phucnv1206/Micromouse/schematic_export.html

⚡ SƠ ĐỒ NGUYÊN LÝ MẠCH ĐIỆN MICROMOUSE STM32F401

Kiến trúc 2 Bus I2C độc lập: I2C1 (3 Cảm biến ToF + DMA) & I2C2 (MPU6050 1000Hz) • EXTI Quadrature Encoders

● Logic 3.3V STM32F401RCT6 (LQFP64)

VCC (+3.3V)

GND (Mass chung)

Bus I2C1 (PB6 SCL / PB7 SDA)

Bus I2C2 (PB10 SCL / PB3 SDA)

Encoders (EXTI11/12, EXTI4/5)

Motor PWM (TIM1_CH1, TIM11_CH1)

UART Telemetry (PA2/PA3)

🔌 Điện Trở Phụ Trợ & Cấu Hình Chân

- • R1, R2 (4.7kΩ): Điện trở kéo lên (Pull-up) cho Bus I2C1 (PB6, PB7) lên 3.3V.
- • R3, R4 (4.7kΩ): Điện trở kéo lên (Pull-up) cho Bus I2C2 (PB10, PB3) lên 3.3V.
- • 330Ω × 3: Trở hạn dòng mắc nối tiếp trước Anode của 3 đèn LED báo trạng thái.
- • PA0, PA1: Nút bấm nối trực tiếp xuống GND (dùng điện trở Pull-up nội bên trong MCU).

⚠️ Quy Chuẩn Đấu Nối Quan Trọng

- • AD0 của MPU6050: Nối cứng xuống GND để cố định địa chỉ I2C 0x68.
- • Chân PB3 (SDA I2C2): Trùng chức năng SWO, dùng mạch nạp SWD bình thường không bị ảnh hưởng.
- • Common Ground (GND chung): Bắt buộc nối Mass chung giữa nguồn Pin, Driver Motor và MCU STM32.
- • Nguồn 3.3V: Cần bộ nguồn LDO/Buck tối thiểu 800mA - 1A để nuôi MCU, 3 Laser ToF và IMU.
