phucnv1206/Micromouse/micromouse_schematic.png

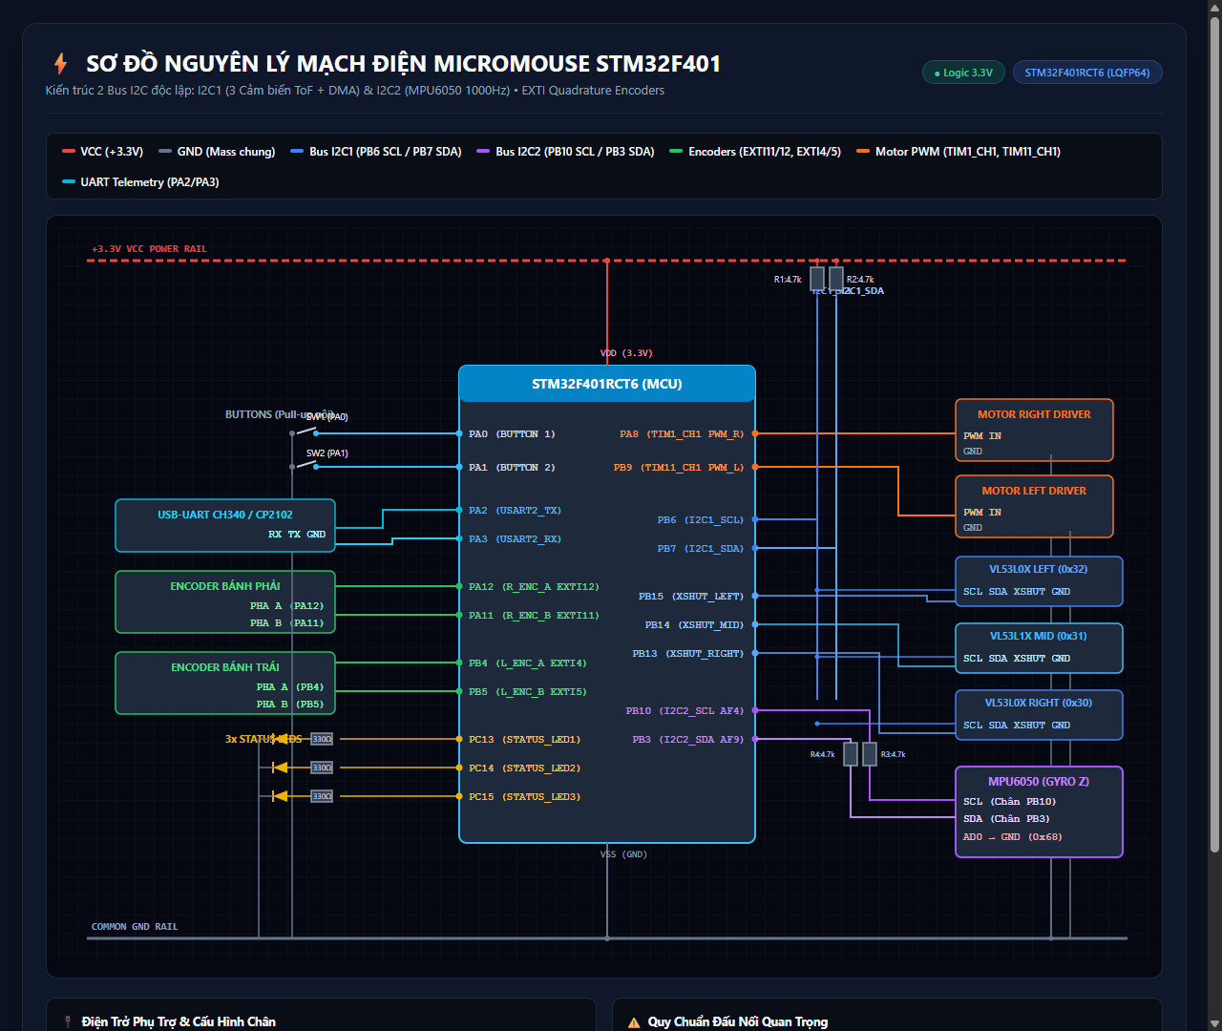
micromouse_schematic.png
