phucnv1206/Micromouse/Src/config.c

#include "main.h"

I2C_HandleTypeDef hi2c1;
DMA_HandleTypeDef hdma_i2c1_rx;
DMA_HandleTypeDef hdma_i2c1_tx;

I2C_HandleTypeDef hi2c2;

TIM_HandleTypeDef htim1;
TIM_HandleTypeDef htim11;

UART_HandleTypeDef huart2;
DMA_HandleTypeDef hdma_usart2_rx;
DMA_HandleTypeDef hdma_usart2_tx;


DMA_HandleTypeDef hdma_memtomem_dma2_stream0;

static void Config_SystemClock_Init(void) {
  RCC_OscInitTypeDef RCC_OscInitStruct = {0};
  RCC_ClkInitTypeDef RCC_ClkInitStruct = {0};

  __HAL_RCC_PWR_CLK_ENABLE();
  __HAL_PWR_VOLTAGESCALING_CONFIG(PWR_REGULATOR_VOLTAGE_SCALE2);

  RCC_OscInitStruct.OscillatorType = RCC_OSCILLATORTYPE_HSI;
  RCC_OscInitStruct.HSIState = RCC_HSI_ON;
  RCC_OscInitStruct.HSICalibrationValue = RCC_HSICALIBRATION_DEFAULT;
  RCC_OscInitStruct.PLL.PLLState = RCC_PLL_ON;
  RCC_OscInitStruct.PLL.PLLSource = RCC_PLLSOURCE_HSI;
  RCC_OscInitStruct.PLL.PLLM = 8;
  RCC_OscInitStruct.PLL.PLLN = 84;
  RCC_OscInitStruct.PLL.PLLP = RCC_PLLP_DIV2;
  RCC_OscInitStruct.PLL.PLLQ = 4;
  if (HAL_RCC_OscConfig(&RCC_OscInitStruct) != HAL_OK) {
    Error_Handler();
  }

  RCC_ClkInitStruct.ClockType = RCC_CLOCKTYPE_HCLK | RCC_CLOCKTYPE_SYSCLK | RCC_CLOCKTYPE_PCLK1 | RCC_CLOCKTYPE_PCLK2;
  RCC_ClkInitStruct.SYSCLKSource = RCC_SYSCLKSOURCE_PLLCLK;
  RCC_ClkInitStruct.AHBCLKDivider = RCC_SYSCLK_DIV1;
  RCC_ClkInitStruct.APB1CLKDivider = RCC_HCLK_DIV2;
  RCC_ClkInitStruct.APB2CLKDivider = RCC_HCLK_DIV1;

  if (HAL_RCC_ClockConfig(&RCC_ClkInitStruct, FLASH_LATENCY_2) != HAL_OK) {
    Error_Handler();
  }
}

static void Config_GPIO_Init(void) {
  GPIO_InitTypeDef GPIO_InitStruct = {0};

  __HAL_RCC_GPIOC_CLK_ENABLE();
  __HAL_RCC_GPIOH_CLK_ENABLE();
  __HAL_RCC_GPIOA_CLK_ENABLE();
  __HAL_RCC_GPIOB_CLK_ENABLE();

  HAL_GPIO_WritePin(LED1_Port, LED1, GPIO_PIN_SET);
  HAL_GPIO_WritePin(LED1_Port, LED2|LED3, GPIO_PIN_RESET);

  GPIO_InitStruct.Pin = LED1|LED2|LED3;
  GPIO_InitStruct.Mode = GPIO_MODE_OUTPUT_PP;
  GPIO_InitStruct.Pull = GPIO_NOPULL;
  GPIO_InitStruct.Speed = GPIO_SPEED_FREQ_LOW;
  HAL_GPIO_Init(LED1_Port, &GPIO_InitStruct);

  GPIO_InitStruct.Pin = BUTTON1|BUTTON2;
  GPIO_InitStruct.Mode = GPIO_MODE_INPUT;
  GPIO_InitStruct.Pull = GPIO_PULLUP;
  HAL_GPIO_Init(BUTTON1_Port, &GPIO_InitStruct);

#if ENCODER_ENABLED
  GPIO_InitStruct.Pin = EN_RIGHT_B|EN_RIGHT_A;
  GPIO_InitStruct.Mode = GPIO_MODE_IT_RISING_FALLING;
  GPIO_InitStruct.Pull = GPIO_NOPULL;
  HAL_GPIO_Init(EN_RIGHT_B_Port, &GPIO_InitStruct);

  GPIO_InitStruct.Pin = EN_LEFT_A|EN_LEFT_B;
  GPIO_InitStruct.Mode = GPIO_MODE_IT_RISING_FALLING;
  GPIO_InitStruct.Pull = GPIO_NOPULL;
  HAL_GPIO_Init(EN_LEFT_A_Port, &GPIO_InitStruct);

  HAL_NVIC_SetPriority(EXTI4_IRQn, 0, 0);
  HAL_NVIC_EnableIRQ(EXTI4_IRQn);
  HAL_NVIC_SetPriority(EXTI9_5_IRQn, 0, 0);
  HAL_NVIC_EnableIRQ(EXTI9_5_IRQn);
  HAL_NVIC_SetPriority(EXTI15_10_IRQn, 0, 0);
  HAL_NVIC_EnableIRQ(EXTI15_10_IRQn);
#endif
}

static void Config_DMA_Init(void) {

  __HAL_RCC_DMA2_CLK_ENABLE();
  __HAL_RCC_DMA1_CLK_ENABLE();

  hdma_memtomem_dma2_stream0.Instance = DMA2_Stream0;
  hdma_memtomem_dma2_stream0.Init.Channel = DMA_CHANNEL_0;
  hdma_memtomem_dma2_stream0.Init.Direction = DMA_MEMORY_TO_MEMORY;
  hdma_memtomem_dma2_stream0.Init.PeriphInc = DMA_PINC_ENABLE;
  hdma_memtomem_dma2_stream0.Init.MemInc = DMA_MINC_ENABLE;
  hdma_memtomem_dma2_stream0.Init.PeriphDataAlignment = DMA_PDATAALIGN_BYTE;
  hdma_memtomem_dma2_stream0.Init.MemDataAlignment = DMA_MDATAALIGN_BYTE;
  hdma_memtomem_dma2_stream0.Init.Mode = DMA_NORMAL;
  hdma_memtomem_dma2_stream0.Init.Priority = DMA_PRIORITY_LOW;
  hdma_memtomem_dma2_stream0.Init.FIFOMode = DMA_FIFOMODE_ENABLE;
  hdma_memtomem_dma2_stream0.Init.FIFOThreshold = DMA_FIFO_THRESHOLD_FULL;
  hdma_memtomem_dma2_stream0.Init.MemBurst = DMA_MBURST_SINGLE;
  hdma_memtomem_dma2_stream0.Init.PeriphBurst = DMA_PBURST_SINGLE;
  if (HAL_DMA_Init(&hdma_memtomem_dma2_stream0) != HAL_OK) {
    Error_Handler();
  }

  HAL_NVIC_SetPriority(DMA1_Stream0_IRQn, 0, 0);
  HAL_NVIC_EnableIRQ(DMA1_Stream0_IRQn);
  HAL_NVIC_SetPriority(DMA1_Stream5_IRQn, 0, 0);
  HAL_NVIC_EnableIRQ(DMA1_Stream5_IRQn);
  HAL_NVIC_SetPriority(DMA1_Stream6_IRQn, 0, 0);
  HAL_NVIC_EnableIRQ(DMA1_Stream6_IRQn);
  HAL_NVIC_SetPriority(DMA1_Stream7_IRQn, 0, 0);
  HAL_NVIC_EnableIRQ(DMA1_Stream7_IRQn);
}

HAL_StatusTypeDef Config_I2C1_Init(void) {
  hi2c1.Instance = I2C1;
  hi2c1.Init.ClockSpeed = I2C_CLOCK_SPEED_HZ;
  hi2c1.Init.DutyCycle = I2C_DUTYCYCLE_2;
  hi2c1.Init.OwnAddress1 = 0;
  hi2c1.Init.AddressingMode = I2C_ADDRESSINGMODE_7BIT;
  hi2c1.Init.DualAddressMode = I2C_DUALADDRESS_DISABLE;
  hi2c1.Init.OwnAddress2 = 0;
  hi2c1.Init.GeneralCallMode = I2C_GENERALCALL_DISABLE;
  hi2c1.Init.NoStretchMode = I2C_NOSTRETCH_DISABLE;
  return HAL_I2C_Init(&hi2c1);
}

HAL_StatusTypeDef Config_I2C2_Init(void) {
  GPIO_InitTypeDef GPIO_InitStruct = {0};

  /*
   * Tắt chức năng SWV (Serial Wire Viewer / TRACESWO) trên chân PB3:
   * Chân PB3 mặc định của STM32F4 có chức năng SYS_JTDO-SWO (AF0).
   * Khi nạp/debug với SWD có bật SWV (Trace Asynchronous Sw), khối DBGMCU
   * sẽ chiếm giữ chân PB3 để xuất xung trace, làm xung đột với I2C2 SDA (AF9).
   * Lệnh dưới đây tắt TRACE IOEN trên DBGMCU để trả chân PB3 về GPIO / Alternate Function thông thường.
   */
  DBGMCU->CR &= ~(DBGMCU_CR_TRACE_IOEN | DBGMCU_CR_TRACE_MODE);

  /* Bật clock GPIO và I2C2 trước khi cấu hình chân và ngoại vi. */
  __HAL_RCC_GPIOB_CLK_ENABLE();
  __HAL_RCC_I2C2_CLK_ENABLE();

  /*
   * PB10 = I2C2_SCL (AF4), PB3 = I2C2_SDA (AF9).
   * Hai chân dùng AF khác nhau nên phải cấu hình riêng từng chân.
   * Module MPU6500 đã có sẵn trở kéo pull-up trên bo nên để GPIO_NOPULL.
   */
  GPIO_InitStruct.Pin = MPU6500_SCL;
  GPIO_InitStruct.Mode = GPIO_MODE_AF_OD;
  GPIO_InitStruct.Pull = GPIO_NOPULL;
  GPIO_InitStruct.Speed = GPIO_SPEED_FREQ_VERY_HIGH;
  GPIO_InitStruct.Alternate = MPU6500_SCL_AF;
  HAL_GPIO_Init(MPU6500_SCL_Port, &GPIO_InitStruct);

  GPIO_InitStruct.Pin = MPU6500_SDA;
  GPIO_InitStruct.Alternate = MPU6500_SDA_AF;
  HAL_GPIO_Init(MPU6500_SDA_Port, &GPIO_InitStruct);

  hi2c2.Instance = I2C2;
  hi2c2.Init.ClockSpeed = MPU6500_I2C_CLOCK_SPEED_HZ;
  hi2c2.Init.DutyCycle = I2C_DUTYCYCLE_2;
  hi2c2.Init.OwnAddress1 = 0;
  hi2c2.Init.AddressingMode = I2C_ADDRESSINGMODE_7BIT;
  hi2c2.Init.DualAddressMode = I2C_DUALADDRESS_DISABLE;
  hi2c2.Init.OwnAddress2 = 0;
  hi2c2.Init.GeneralCallMode = I2C_GENERALCALL_DISABLE;
  hi2c2.Init.NoStretchMode = I2C_NOSTRETCH_DISABLE;
  return HAL_I2C_Init(&hi2c2);
}

static void Config_TIM1_Init(void) {
  TIM_ClockConfigTypeDef sClockSourceConfig = {0};
  TIM_MasterConfigTypeDef sMasterConfig = {0};
  TIM_OC_InitTypeDef sConfigOC = {0};
  TIM_BreakDeadTimeConfigTypeDef sBreakDeadTimeConfig = {0};

  htim1.Instance = TIM1;
  htim1.Init.Prescaler = (SystemCoreClock / MOTOR_PWM_COUNTER_HZ) - 1U;
  htim1.Init.CounterMode = TIM_COUNTERMODE_UP;
  htim1.Init.Period = (MOTOR_PWM_COUNTER_HZ / MOTOR_PWM_FREQUENCY_HZ) - 1U;
  htim1.Init.ClockDivision = TIM_CLOCKDIVISION_DIV1;
  htim1.Init.RepetitionCounter = 0;
  htim1.Init.AutoReloadPreload = TIM_AUTORELOAD_PRELOAD_DISABLE;
  if (HAL_TIM_Base_Init(&htim1) != HAL_OK) {
    Error_Handler();
  }

  sClockSourceConfig.ClockSource = TIM_CLOCKSOURCE_INTERNAL;
  if (HAL_TIM_ConfigClockSource(&htim1, &sClockSourceConfig) != HAL_OK) {
    Error_Handler();
  }
  if (HAL_TIM_PWM_Init(&htim1) != HAL_OK) {
    Error_Handler();
  }

  sMasterConfig.MasterOutputTrigger = TIM_TRGO_RESET;
  sMasterConfig.MasterSlaveMode = TIM_MASTERSLAVEMODE_DISABLE;
  if (HAL_TIMEx_MasterConfigSynchronization(&htim1, &sMasterConfig) != HAL_OK) {
    Error_Handler();
  }

  sConfigOC.OCMode = TIM_OCMODE_PWM1;
  sConfigOC.Pulse = 0;
  sConfigOC.OCPolarity = TIM_OCPOLARITY_HIGH;
  sConfigOC.OCNPolarity = TIM_OCNPOLARITY_HIGH;
  sConfigOC.OCFastMode = TIM_OCFAST_DISABLE;
  sConfigOC.OCIdleState = TIM_OCIDLESTATE_RESET;
  sConfigOC.OCNIdleState = TIM_OCNIDLESTATE_RESET;
  if (HAL_TIM_PWM_ConfigChannel(&htim1, &sConfigOC, TIM_CHANNEL_1) != HAL_OK) {
    Error_Handler();
  }

  sBreakDeadTimeConfig.OffStateRunMode = TIM_OSSR_DISABLE;
  sBreakDeadTimeConfig.OffStateIDLEMode = TIM_OSSI_DISABLE;
  sBreakDeadTimeConfig.LockLevel = TIM_LOCKLEVEL_OFF;
  sBreakDeadTimeConfig.DeadTime = 0;
  sBreakDeadTimeConfig.BreakState = TIM_BREAK_DISABLE;
  sBreakDeadTimeConfig.BreakPolarity = TIM_BREAKPOLARITY_HIGH;
  sBreakDeadTimeConfig.AutomaticOutput = TIM_AUTOMATICOUTPUT_DISABLE;
  if (HAL_TIMEx_ConfigBreakDeadTime(&htim1, &sBreakDeadTimeConfig) != HAL_OK) {
    Error_Handler();
  }
  HAL_TIM_MspPostInit(&htim1);
}

static void Config_TIM11_Init(void) {
  TIM_OC_InitTypeDef sConfigOC = {0};

  htim11.Instance = TIM11;
  htim11.Init.Prescaler = (SystemCoreClock / MOTOR_PWM_COUNTER_HZ) - 1U;
  htim11.Init.CounterMode = TIM_COUNTERMODE_UP;
  htim11.Init.Period = (MOTOR_PWM_COUNTER_HZ / MOTOR_PWM_FREQUENCY_HZ) - 1U;
  htim11.Init.ClockDivision = TIM_CLOCKDIVISION_DIV1;
  htim11.Init.AutoReloadPreload = TIM_AUTORELOAD_PRELOAD_DISABLE;
  if (HAL_TIM_Base_Init(&htim11) != HAL_OK) {
    Error_Handler();
  }
  if (HAL_TIM_PWM_Init(&htim11) != HAL_OK) {
    Error_Handler();
  }

  sConfigOC.OCMode = TIM_OCMODE_PWM1;
  sConfigOC.Pulse = 0;
  sConfigOC.OCPolarity = TIM_OCPOLARITY_HIGH;
  sConfigOC.OCFastMode = TIM_OCFAST_DISABLE;
  if (HAL_TIM_PWM_ConfigChannel(&htim11, &sConfigOC, TIM_CHANNEL_1) != HAL_OK) {
    Error_Handler();
  }
  HAL_TIM_MspPostInit(&htim11);
}

static void Config_USART2_Init(void) {

  huart2.Instance = USART2;
  huart2.Init.BaudRate = 921600;
  huart2.Init.WordLength = UART_WORDLENGTH_8B;
  huart2.Init.StopBits = UART_STOPBITS_1;
  huart2.Init.Parity = UART_PARITY_NONE;
  huart2.Init.Mode = UART_MODE_TX_RX;
  huart2.Init.HwFlowCtl = UART_HWCONTROL_NONE;
  huart2.Init.OverSampling = UART_OVERSAMPLING_16;
  if (HAL_UART_Init(&huart2) != HAL_OK) {
    Error_Handler();
  }
}

void Config_Init(void) {
  Config_SystemClock_Init();
  Config_GPIO_Init();
  Config_DMA_Init();
  Config_TIM1_Init();
  Config_TIM11_Init();
  Config_USART2_Init();
}

HAL_StatusTypeDef Config_OdometryTimer_Init(void) {
#if ODOMETRY_ENABLED
  if (SystemCoreClock < ODOMETRY_TIMER_COUNTER_HZ || SystemCoreClock % ODOMETRY_TIMER_COUNTER_HZ != 0U) {
    return HAL_ERROR;
  }

  __HAL_RCC_TIM3_CLK_ENABLE();
  TIM3->CR1 = 0U;
  TIM3->PSC = (SystemCoreClock / ODOMETRY_TIMER_COUNTER_HZ) - 1U;
  TIM3->ARR = (ODOMETRY_TIMER_COUNTER_HZ / ODOMETRY_UPDATE_FREQUENCY_HZ) - 1U;
  TIM3->EGR = TIM_EGR_UG;
  TIM3->SR = 0U;

  HAL_NVIC_SetPriority(TIM3_IRQn, 1U, 0U);
  HAL_NVIC_EnableIRQ(TIM3_IRQn);
#endif

  return HAL_OK;
}

void Config_OdometryTimer_Start(void) {
#if ODOMETRY_ENABLED
  TIM3->CNT = 0U;
  TIM3->SR = 0U;
  TIM3->DIER |= TIM_DIER_UIE;
  TIM3->CR1 |= TIM_CR1_CEN;
#endif
}

void Config_I2C1_GPIO_Init(void) {
  GPIO_InitTypeDef GPIO_InitStruct = {0};

  __HAL_RCC_GPIOB_CLK_ENABLE();
  GPIO_InitStruct.Pin = SCL|SDA;
  GPIO_InitStruct.Mode = GPIO_MODE_AF_OD;
  GPIO_InitStruct.Pull = GPIO_NOPULL;
  GPIO_InitStruct.Speed = GPIO_SPEED_FREQ_VERY_HIGH;
  GPIO_InitStruct.Alternate = GPIO_AF4_I2C1;
  HAL_GPIO_Init(SCL_Port, &GPIO_InitStruct);
}

void Config_I2C1_GPIO_DeInit(void) {
  HAL_GPIO_DeInit(SCL_Port, SCL);
  HAL_GPIO_DeInit(SDA_Port, SDA);
}

void Config_TIM1_GPIO_Init(void) {
  GPIO_InitTypeDef GPIO_InitStruct = {0};

  __HAL_RCC_GPIOA_CLK_ENABLE();
  GPIO_InitStruct.Pin = MOTOR_RIGHT;
  GPIO_InitStruct.Mode = GPIO_MODE_AF_PP;
  GPIO_InitStruct.Pull = GPIO_NOPULL;
  GPIO_InitStruct.Speed = GPIO_SPEED_FREQ_LOW;
  GPIO_InitStruct.Alternate = GPIO_AF1_TIM1;
  HAL_GPIO_Init(MOTOR_RIGHT_Port, &GPIO_InitStruct);
}

void Config_TIM11_GPIO_Init(void) {
  GPIO_InitTypeDef GPIO_InitStruct = {0};

  __HAL_RCC_GPIOB_CLK_ENABLE();
  GPIO_InitStruct.Pin = MOTOR_LEFT;
  GPIO_InitStruct.Mode = GPIO_MODE_AF_PP;
  GPIO_InitStruct.Pull = GPIO_NOPULL;
  GPIO_InitStruct.Speed = GPIO_SPEED_FREQ_LOW;
  GPIO_InitStruct.Alternate = GPIO_AF3_TIM11;
  HAL_GPIO_Init(MOTOR_LEFT_Port, &GPIO_InitStruct);
}

void Config_USART2_GPIO_Init(void) {
  GPIO_InitTypeDef GPIO_InitStruct = {0};

  __HAL_RCC_GPIOA_CLK_ENABLE();
  GPIO_InitStruct.Pin = TX|RX;
  GPIO_InitStruct.Mode = GPIO_MODE_AF_PP;
  GPIO_InitStruct.Pull = GPIO_NOPULL;
  GPIO_InitStruct.Speed = GPIO_SPEED_FREQ_VERY_HIGH;
  GPIO_InitStruct.Alternate = GPIO_AF7_USART2;
  HAL_GPIO_Init(TX_Port, &GPIO_InitStruct);
}

void Config_USART2_GPIO_DeInit(void) {
  HAL_GPIO_DeInit(TX_Port, TX|RX);
}
