phucnv1206/Micromouse/Src/tof_sensors.c

#include <string.h>
#include "main.h"
#include "config.h"
#include "i2c_bus.h"
#include "tof_sensors.h"
#include "VL53L1X_api.h"

extern I2C_HandleTypeDef hi2c1;

#define VL53L0X_DEFAULT_ADDRESS_8BIT (VL53L0X_DEFAULT_I2C_ADDRESS << 1U)
#define VL53L0X_SHORT_PRE_RANGE_VCSEL_PERIOD 14U
#define VL53L0X_SHORT_FINAL_RANGE_VCSEL_PERIOD 10U
#define VL53L0X_SHORT_SIGNAL_RATE_LIMIT_MCPS 0x0000199AU

typedef struct {
  TofXshut_Sensor sensor;
  uint8_t address7Bit;
  uint32_t timingBudgetUs;
  VL53L0X_Dev_t driver;
  uint8_t initialized;
} TofSensors_Device;

static TofSensors_Device devices[TOF_SENSOR_COUNT];
static uint16_t distanceMm[TOF_SENSOR_COUNT];
static uint8_t distanceFilterInitialized[TOF_SENSOR_COUNT];
static VL53L0X_Error lastError = VL53L0X_ERROR_NONE;
static VL53L1X_ERROR lastL1Error = 0;
static TofSensors_InitStage lastInitStage = TOF_INIT_STAGE_NONE;
static TofXshut_Sensor lastInitSensor = TOF_SENSOR_RIGHT;

typedef struct {
  uint16_t raw;
  uint16_t actual;
} TofSensors_CalibPoint;

#define TOF_CALIB_MAX_DISTANCE_MM 500U

/* Bảng ánh xạ thực nghiệm cho cảm biến RIGHT (VL53L0X) */
static const TofSensors_CalibPoint calibRightTable[] = {
  { 76U,  50U},
  { 84U,  60U},
  {105U,  80U},
  {127U, 100U},
  {145U, 120U},
  {180U, 150U},
  {240U, 200U},
  {280U, 250U},
  {330U, 300U},
  {380U, 350U},
  {420U, 400U},
  {460U, 450U},
  {500U, 500U}
};

/* Bảng ánh xạ thực nghiệm cho cảm biến MID (VL53L1X) */
static const TofSensors_CalibPoint calibMidTable[] = {
  { 33U,  50U},
  { 45U,  60U},
  { 65U,  80U},
  { 90U, 100U},
  {110U, 120U},
  {140U, 150U},
  {190U, 200U},
  {238U, 250U},
  {286U, 300U},
  {325U, 350U},
  {372U, 400U},
  {424U, 450U},
  {470U, 500U},
  {500U, 500U}
};

/* Bảng ánh xạ thực nghiệm cho cảm biến LEFT (VL53L0X) */
static const TofSensors_CalibPoint calibLeftTable[] = {
  { 50U,  50U},
  { 60U,  60U},
  { 80U,  80U},
  {100U, 100U},
  {124U, 120U},
  {160U, 150U},
  {218U, 200U},
  {270U, 250U},
  {320U, 300U},
  {370U, 350U},
  {415U, 400U},
  {460U, 450U},
  {500U, 500U}
};

static uint16_t TofSensors_Interpolate(uint16_t rawMm, const TofSensors_CalibPoint *table, uint8_t count) {
  /* Trên 500mm hoặc vượt quá ngưỡng đo trong bảng: không cần hiệu chuẩn, giữ nguyên raw */
  if (rawMm >= TOF_CALIB_MAX_DISTANCE_MM || rawMm >= table[count - 1U].raw) {
    return rawMm;
  }

  /* Dưới điểm đo đầu tiên: ngoại suy tuyến tính theo đoạn đầu tiên để không bị nhảy nấc */
  if (rawMm <= table[0U].raw) {
    int32_t dy = (int32_t)table[1U].actual - (int32_t)table[0U].actual;
    int32_t dx = (int32_t)table[1U].raw - (int32_t)table[0U].raw;
    if (dx <= 0) {
      return table[0U].actual;
    }
    int32_t diff = (int32_t)rawMm - (int32_t)table[0U].raw;
    int32_t val = (int32_t)table[0U].actual + (diff * dy) / dx;
    if (val < 0) {
      return 0U;
    }
    return (uint16_t)val;
  }

  /* Nội suy tuyến tính từng đoạn (Piecewise Linear Interpolation) */
  for (uint8_t i = 0U; i < (count - 1U); i++) {
    if (rawMm <= table[i + 1U].raw) {
      uint32_t dx = (uint32_t)(table[i + 1U].raw - table[i].raw);
      if (dx == 0U) {
        return table[i].actual;
      }
      uint32_t dy = (uint32_t)(table[i + 1U].actual - table[i].actual);
      uint32_t diff = (uint32_t)(rawMm - table[i].raw);
      return (uint16_t)(table[i].actual + (diff * dy + (dx / 2U)) / dx);
    }
  }

  return rawMm;
}

uint16_t TofSensors_CalibrateDistance(TofXshut_Sensor sensor, uint16_t rawMm) {
  switch (sensor) {
    case TOF_SENSOR_LEFT:
      return TofSensors_Interpolate(rawMm, calibLeftTable, (uint8_t)(sizeof(calibLeftTable) / sizeof(calibLeftTable[0])));
    case TOF_SENSOR_MID:
      return TofSensors_Interpolate(rawMm, calibMidTable, (uint8_t)(sizeof(calibMidTable) / sizeof(calibMidTable[0])));
    case TOF_SENSOR_RIGHT:
      return TofSensors_Interpolate(rawMm, calibRightTable, (uint8_t)(sizeof(calibRightTable) / sizeof(calibRightTable[0])));
    default:
      return rawMm;
  }
}

static void TofSensors_UpdateFilteredDistance(TofXshut_Sensor sensor, uint16_t measurementMm) {
  uint16_t calibratedMm = TofSensors_CalibrateDistance(sensor, measurementMm);
  if (distanceFilterInitialized[sensor] == 0U) {
    distanceMm[sensor] = calibratedMm;
    distanceFilterInitialized[sensor] = 1U;
  } else {
    uint32_t filtered = (uint32_t)distanceMm[sensor] * (100U - TOF_LOWPASS_ALPHA_PERCENT)
        + (uint32_t)calibratedMm * TOF_LOWPASS_ALPHA_PERCENT;
    distanceMm[sensor] = (uint16_t)((filtered + 50U) / 100U);
  }
}

static bool TofSensors_ReturnResults(uint16_t *leftMm, uint16_t *midMm, uint16_t *rightMm,
                                     bool apiSuccess) {
  *leftMm = distanceMm[TOF_SENSOR_LEFT];
  *midMm = distanceMm[TOF_SENSOR_MID];
  *rightMm = distanceMm[TOF_SENSOR_RIGHT];
  return apiSuccess;
}

/* Giữ mã lỗi API ST để bên gọi có thể chẩn đoán khi khởi tạo thất bại. */
static HAL_StatusTypeDef TofSensors_CheckApiStatus(VL53L0X_Error status) {
  lastError = status;
  return status == VL53L0X_ERROR_NONE ? HAL_OK : HAL_ERROR;
}

static HAL_StatusTypeDef TofSensors_ConfigureMidDevice(TofSensors_Device *device) {
  const uint16_t defaultAddress = (uint16_t)(VL53L0X_DEFAULT_I2C_ADDRESS << 1U);
  const uint16_t deviceAddress = (uint16_t)(device->address7Bit << 1U);
  uint16_t currentAddress = defaultAddress;

  lastInitStage = TOF_INIT_STAGE_L1_SENSOR_INIT;
  lastL1Error = VL53L1X_SensorInit(currentAddress);
  if (lastL1Error != 0) {
    return HAL_ERROR;
  }

  lastInitStage = TOF_INIT_STAGE_L1_SET_ADDRESS;
  lastL1Error = VL53L1X_SetI2CAddress(currentAddress, (uint8_t)deviceAddress);
  if (lastL1Error != 0) {
    return HAL_ERROR;
  }
  currentAddress = deviceAddress;

  lastInitStage = TOF_INIT_STAGE_L1_SHORT_MODE;
  lastL1Error = VL53L1X_SetDistanceMode(currentAddress, 1U);
  if (lastL1Error != 0) {
    return HAL_ERROR;
  }
  lastInitStage = TOF_INIT_STAGE_L1_TIMING_BUDGET;
  lastL1Error = VL53L1X_SetTimingBudgetInMs(currentAddress, TOF_MID_TIMING_BUDGET_MS);
  if (lastL1Error != 0) {
    return HAL_ERROR;
  }
  uint16_t timingBudgetMs = 0U;
  lastL1Error = VL53L1X_GetTimingBudgetInMs(currentAddress, &timingBudgetMs);
  if (lastL1Error != 0 || timingBudgetMs != TOF_MID_TIMING_BUDGET_MS) {
    if (lastL1Error == 0) {
      lastL1Error = 1;
    }
    return HAL_ERROR;
  }
  lastInitStage = TOF_INIT_STAGE_L1_INTER_MEASUREMENT;
  lastL1Error = VL53L1X_SetInterMeasurementInMs(currentAddress, TOF_MID_INTER_MEASUREMENT_MS);
  if (lastL1Error != 0) {
    return HAL_ERROR;
  }
  uint16_t interMeasurementMs = 0U;
  lastL1Error = VL53L1X_GetInterMeasurementInMs(currentAddress, &interMeasurementMs);
  if (lastL1Error != 0 || interMeasurementMs != TOF_MID_INTER_MEASUREMENT_MS) {
    if (lastL1Error == 0) {
      lastL1Error = 1;
    }
    return HAL_ERROR;
  }
  lastInitStage = TOF_INIT_STAGE_L1_START_RANGING;
  lastL1Error = VL53L1X_StartRanging(currentAddress);
  if (lastL1Error != 0) {
    return HAL_ERROR;
  }

  device->initialized = 1U;
  return HAL_OK;
}

static HAL_StatusTypeDef TofSensors_ConfigureDevice(TofSensors_Device *device) {
  uint8_t vhvSettings;
  uint8_t phaseCal;
  uint32_t referenceSpadCount;
  uint8_t isApertureSpads;
  VL53L0X_Error status;

  if (device->sensor == TOF_SENSOR_MID) {
    return TofSensors_ConfigureMidDevice(device);
  }

  memset(&device->driver, 0, sizeof(device->driver));
  device->driver.I2cHandle = &hi2c1;
  /* Driver ST nhận địa chỉ ở dạng 8-bit; địa chỉ cấu hình bên ngoài là 7-bit. */
  device->driver.I2cDevAddr = VL53L0X_DEFAULT_ADDRESS_8BIT;

  lastInitStage = TOF_INIT_STAGE_DATA_INIT;
  status = VL53L0X_DataInit(&device->driver);
  if (TofSensors_CheckApiStatus(status) != HAL_OK) {
    return HAL_ERROR;
  }

  lastInitStage = TOF_INIT_STAGE_SET_ADDRESS;
  status = VL53L0X_SetDeviceAddress(&device->driver, (uint8_t)(device->address7Bit << 1U));
  if (TofSensors_CheckApiStatus(status) != HAL_OK) {
    return HAL_ERROR;
  }
  device->driver.I2cDevAddr = (uint8_t)(device->address7Bit << 1U);

  /* Chạy cấu hình tĩnh, hiệu chuẩn tham chiếu/SPAD trước khi chọn chế độ đo. */
  lastInitStage = TOF_INIT_STAGE_STATIC_INIT;
  status = VL53L0X_StaticInit(&device->driver);
  if (TofSensors_CheckApiStatus(status) != HAL_OK) {
    return HAL_ERROR;
  }
  lastInitStage = TOF_INIT_STAGE_REF_CALIBRATION;
  status = VL53L0X_PerformRefCalibration(&device->driver, &vhvSettings, &phaseCal);
  if (TofSensors_CheckApiStatus(status) != HAL_OK) {
    return HAL_ERROR;
  }
  lastInitStage = TOF_INIT_STAGE_REF_SPAD;
  status = VL53L0X_PerformRefSpadManagement(&device->driver, &referenceSpadCount, &isApertureSpads);
  if (TofSensors_CheckApiStatus(status) != HAL_OK) {
    return HAL_ERROR;
  }

  /* Cấu hình short-range: VCSEL period ngắn và ngưỡng signal-rate 0,1 MCPS. */
  lastInitStage = TOF_INIT_STAGE_SHORT_PRE_RANGE;
  status = VL53L0X_SetVcselPulsePeriod(&device->driver, VL53L0X_VCSEL_PERIOD_PRE_RANGE, VL53L0X_SHORT_PRE_RANGE_VCSEL_PERIOD);
  if (TofSensors_CheckApiStatus(status) != HAL_OK) {
    return HAL_ERROR;
  }
  lastInitStage = TOF_INIT_STAGE_SHORT_FINAL_RANGE;
  status = VL53L0X_SetVcselPulsePeriod(&device->driver, VL53L0X_VCSEL_PERIOD_FINAL_RANGE, VL53L0X_SHORT_FINAL_RANGE_VCSEL_PERIOD);
  if (TofSensors_CheckApiStatus(status) != HAL_OK) {
    return HAL_ERROR;
  }
  lastInitStage = TOF_INIT_STAGE_SIGNAL_RATE;
  status = VL53L0X_SetLimitCheckValue(&device->driver, VL53L0X_CHECKENABLE_SIGNAL_RATE_FINAL_RANGE, VL53L0X_SHORT_SIGNAL_RATE_LIMIT_MCPS);
  if (TofSensors_CheckApiStatus(status) != HAL_OK) {
    return HAL_ERROR;
  }

  lastInitStage = TOF_INIT_STAGE_SET_MODE;
  status = VL53L0X_SetDeviceMode(&device->driver, VL53L0X_DEVICEMODE_CONTINUOUS_RANGING);
  if (TofSensors_CheckApiStatus(status) != HAL_OK) {
    return HAL_ERROR;
  }
  lastInitStage = TOF_INIT_STAGE_TIMING_BUDGET;
  status = VL53L0X_SetMeasurementTimingBudgetMicroSeconds(&device->driver, device->timingBudgetUs);
  if (TofSensors_CheckApiStatus(status) != HAL_OK) {
    return HAL_ERROR;
  }
  lastInitStage = TOF_INIT_STAGE_START_MEASUREMENT;
  status = VL53L0X_StartMeasurement(&device->driver);
  if (TofSensors_CheckApiStatus(status) != HAL_OK) {
    return HAL_ERROR;
  }

  device->initialized = 1U;
  return HAL_OK;
}

HAL_StatusTypeDef TofSensors_Init(void) {
  lastError = VL53L0X_ERROR_NONE;
  lastL1Error = 0;
  memset(distanceMm, 0, sizeof(distanceMm));
  memset(distanceFilterInitialized, 0, sizeof(distanceFilterInitialized));
  lastInitStage = TOF_INIT_STAGE_NONE;
  lastInitSensor = TOF_SENSOR_RIGHT;

  devices[TOF_SENSOR_RIGHT].sensor = TOF_SENSOR_RIGHT;
  devices[TOF_SENSOR_RIGHT].address7Bit = TOF_SENSOR_RIGHT_I2C_ADDRESS;
  devices[TOF_SENSOR_RIGHT].timingBudgetUs = TOF_OUTER_MEASUREMENT_TIMING_BUDGET_US;
  devices[TOF_SENSOR_MID].sensor = TOF_SENSOR_MID;
  devices[TOF_SENSOR_MID].address7Bit = TOF_SENSOR_MID_I2C_ADDRESS;
  devices[TOF_SENSOR_MID].timingBudgetUs = 0U;
  devices[TOF_SENSOR_LEFT].sensor = TOF_SENSOR_LEFT;
  devices[TOF_SENSOR_LEFT].address7Bit = TOF_SENSOR_LEFT_I2C_ADDRESS;
  devices[TOF_SENSOR_LEFT].timingBudgetUs = TOF_OUTER_MEASUREMENT_TIMING_BUDGET_US;

  /* Tắt cả ba cảm biến trước, để chỉ cảm biến đang cấu hình dùng địa chỉ mặc định. */
  TofXshut_Init();
  for (uint32_t i = 0U; i < TOF_SENSOR_COUNT; i++) {
    devices[i].initialized = 0U;
  }

  HAL_Delay(TOF_XSHUT_RESET_DELAY_MS);
  lastInitStage = TOF_INIT_STAGE_I2C;
  if (I2cBus_Init() != HAL_OK) {
    lastError = VL53L0X_ERROR_CONTROL_INTERFACE;
    return HAL_ERROR;
  }

  for (uint32_t i = 0U; i < TOF_SENSOR_COUNT; i++) {
    /* Bật từng cảm biến, đợi boot, đổi địa chỉ rồi mới bật cảm biến kế tiếp. */
    lastInitSensor = devices[i].sensor;
    lastInitStage = TOF_INIT_STAGE_XSHUT;
    if (TofXshut_Set(devices[i].sensor, true) != HAL_OK) {
      lastError = VL53L0X_ERROR_CONTROL_INTERFACE;
      goto initialization_failed;
    }
    HAL_Delay(TOF_SENSOR_BOOT_DELAY_MS);
    lastInitStage = TOF_INIT_STAGE_DEVICE_READY;
    if (I2cBus_IsDeviceReady(VL53L0X_DEFAULT_I2C_ADDRESS, 3U) != HAL_OK) {
      lastError = VL53L0X_ERROR_CONTROL_INTERFACE;
      goto initialization_failed;
    }
    if (TofSensors_ConfigureDevice(&devices[i]) != HAL_OK) {
      goto initialization_failed;
    }
    if (i + 1U < TOF_SENSOR_COUNT) {
      HAL_Delay(TOF_SENSOR_INTER_INIT_DELAY_MS);
    }
  }

  return HAL_OK;

initialization_failed:
  /* Tắt cảm biến lỗi; giữ nguyên trạng thái của các cảm biến init thành công. */
  TofXshut_Set(lastInitSensor, false);
  devices[lastInitSensor].initialized = 0U;
  return HAL_ERROR;
}

bool TofSensors_UpdateDistances(uint16_t *leftMm, uint16_t *midMm, uint16_t *rightMm,
                                bool *leftValid, bool *midValid, bool *rightValid) {
  if (leftMm == NULL || midMm == NULL || rightMm == NULL
      || leftValid == NULL || midValid == NULL || rightValid == NULL) {
    return false;
  }

#if !TOF_ENABLED
  *leftMm = 0U;
  *midMm = 0U;
  *rightMm = 0U;
  *leftValid = false;
  *midValid = false;
  *rightValid = false;
  return false;
#else
  *leftValid = false;
  *midValid = false;
  *rightValid = false;

  VL53L0X_RangingMeasurementData_t measurement;
  VL53L0X_DEV device;
  uint8_t dataReady = 0U;
  uint8_t rangeStatus = 0U;
  uint16_t midDistance = 0U;
  VL53L0X_Error l0Status;

  if (devices[TOF_SENSOR_LEFT].initialized == 0U
      || devices[TOF_SENSOR_MID].initialized == 0U
      || devices[TOF_SENSOR_RIGHT].initialized == 0U) {
    *leftMm = 0U;
    *midMm = 0U;
    *rightMm = 0U;
    return false;
  }

  device = &devices[TOF_SENSOR_LEFT].driver;
  l0Status = VL53L0X_GetMeasurementDataReady(device, &dataReady);
  if (TofSensors_CheckApiStatus(l0Status) != HAL_OK) {
    return TofSensors_ReturnResults(leftMm, midMm, rightMm, false);
  }
  if (dataReady != 0U) {
    l0Status = VL53L0X_GetRangingMeasurementData(device, &measurement);
    if (TofSensors_CheckApiStatus(l0Status) != HAL_OK) {
      return TofSensors_ReturnResults(leftMm, midMm, rightMm, false);
    }
    l0Status = VL53L0X_ClearInterruptMask(device, 0U);
    if (TofSensors_CheckApiStatus(l0Status) != HAL_OK) {
      return TofSensors_ReturnResults(leftMm, midMm, rightMm, false);
    }
    if (measurement.RangeStatus == 0U) {
      TofSensors_UpdateFilteredDistance(TOF_SENSOR_LEFT, measurement.RangeMilliMeter);
      *leftValid = true;
    }
  }

  dataReady = 0U;
  lastL1Error = VL53L1X_CheckForDataReady(
      (uint16_t)(TOF_SENSOR_MID_I2C_ADDRESS << 1U), &dataReady);
  if (lastL1Error != 0) {
    return TofSensors_ReturnResults(leftMm, midMm, rightMm, false);
  }
  if (dataReady != 0U) {
    lastL1Error = VL53L1X_GetRangeStatus(
        (uint16_t)(TOF_SENSOR_MID_I2C_ADDRESS << 1U), &rangeStatus);
    if (lastL1Error != 0) {
      return TofSensors_ReturnResults(leftMm, midMm, rightMm, false);
    }
    lastL1Error = VL53L1X_GetDistance(
        (uint16_t)(TOF_SENSOR_MID_I2C_ADDRESS << 1U), &midDistance);
    if (lastL1Error != 0) {
      return TofSensors_ReturnResults(leftMm, midMm, rightMm, false);
    }
    lastL1Error = VL53L1X_ClearInterrupt(
        (uint16_t)(TOF_SENSOR_MID_I2C_ADDRESS << 1U));
    if (lastL1Error != 0) {
      return TofSensors_ReturnResults(leftMm, midMm, rightMm, false);
    }
    if (rangeStatus == 0U) {
      TofSensors_UpdateFilteredDistance(TOF_SENSOR_MID, midDistance);
      *midValid = true;
    }
  }

  device = &devices[TOF_SENSOR_RIGHT].driver;
  dataReady = 0U;
  l0Status = VL53L0X_GetMeasurementDataReady(device, &dataReady);
  if (TofSensors_CheckApiStatus(l0Status) != HAL_OK) {
    return TofSensors_ReturnResults(leftMm, midMm, rightMm, false);
  }
  if (dataReady != 0U) {
    l0Status = VL53L0X_GetRangingMeasurementData(device, &measurement);
    if (TofSensors_CheckApiStatus(l0Status) != HAL_OK) {
      return TofSensors_ReturnResults(leftMm, midMm, rightMm, false);
    }
    l0Status = VL53L0X_ClearInterruptMask(device, 0U);
    if (TofSensors_CheckApiStatus(l0Status) != HAL_OK) {
      return TofSensors_ReturnResults(leftMm, midMm, rightMm, false);
    }
    if (measurement.RangeStatus == 0U) {
      TofSensors_UpdateFilteredDistance(TOF_SENSOR_RIGHT, measurement.RangeMilliMeter);
      *rightValid = true;
    }
  }

  return TofSensors_ReturnResults(leftMm, midMm, rightMm, true);
#endif
}

VL53L0X_Error TofSensors_GetLastError(void) {
  return lastError;
}

int8_t TofSensors_GetLastL1Error(void) {
  return lastL1Error;
}

TofSensors_InitStage TofSensors_GetLastInitStage(void) {
  return lastInitStage;
}

TofXshut_Sensor TofSensors_GetLastInitSensor(void) {
  return lastInitSensor;
}

VL53L0X_DEV TofSensors_GetDevice(TofXshut_Sensor sensor) {
  if ((uint32_t)sensor >= TOF_SENSOR_COUNT || sensor == TOF_SENSOR_MID
      || devices[sensor].initialized == 0U) {
    return NULL;
  }

  return &devices[sensor].driver;
}
